hbtounes/projet-Arduino-Bentounes-Cayla/README.md

# projet-Arduino
Projet Arduino Hussein Ben Tounes Guillaume Cayla
