hbtounes/projet-Arduino-Bentounes-Cayla/Cayla Guillaume/rapport-seance-8.md

Durant cette 8ème séance, le bur était d'avancer sur le montage du bras+pince. Pour cela, je devais percer une sorte de petit écrou noir afin de pouvoir fixer les gros servomoteurs sur les éléments du bras. J'ai donc pris une mèche de 3mm et j'ai répété cette action sur 4 de ces petis objets noirs. Ensuite, j'ai dû trouver un moyen de visser ces derniers sur le bras et faire en sorte que la fixation soit solide et tienne bien. Pour cela, j'ai simplement trouver des entretoises du même diamètre que chaque vis et je les mises bout à bout comme cela : 



On peut donc remarquer que les servomoteurs sont fixés au bras à l'aide de ces 4 petits outils même si l'on ne voit rien.



De plus, durant cette séance, avec mon collègue Hussein, on a finalement réussi à faire tourner le moteur pas à pas à l'aide du téléphone via bluetooth :



Sur ces 3 boutons, l'un permet de le faire tourner dans le sens des aiguilles d'une montre, le second dans l'autre sens et enfin le dernier permet d'arrêter la rotation.
Par rapport au brannchement concernant le moteur pas à pas, le voici : 





On a vu dans la documentation de Pascal Masson que le moteur pas à pas nécessitait un driver A4988. En effet ce driver permet un contrôle très simple du moteur pas à pas. Ce montage nécessite une capacité de découplage pour l’alimentation du
moteur afin de lisser les appels de courant des bobines

Finalement je pense avoir plutot bien respecté le diagramme de Gantt : 
