hbtounes/projet-Arduino-Bentounes-Cayla/Cayla Guillaume/rapport-seance-7.md

Durant cette 7ème séance, mon rôle était de m'occuper de la partie bluetooth du projet. Pour cela je devais d'abord me concentrer sur le contrôle du moteur DC via le téléphone. Pour cela, il a fallut connecter le module bluetooth à la carte Arduino comme on peut le voir sur la photo ci-dessous.



Ensuite, il a fallut que je me familiarise avec l'application mobile "Bluetooth Electronics" déjà installée lors d'un TD en début d'année. J'ai donc dû faire mes recherches et trouver des tutos ou bien des indications concernant l'utilisation de cette application. Suite à cela, j'ai également regardé le contrôle bluetooth dans le cadre du code sur Arduino IDE. 



On peut voir dans le code ci-dessus la création de deux variables : un "int" (PWM) et un "char" (DATA). En effet le caractère char va permettre de stocker un caractère et par la suite d'introduire toutes les conditions nécessaires au bon fonctionnement du projet. C'est-à-dire que sur l'application, on caractérise la bifurcation vers la droite de la voiture à l'aide de la lettre "R" (Right). 



Cette même lettre va être stocké dans la variable DATA et on pourra créer les premières conditions pour que la voiture tourne à droite. Ensuite je n'ai plus qu'a coder l'action de tourner les roues avant et voilà le tour est joué !



Maintenant, par rapport à la variable "int", cette dernière va servir à stocker la valeur que l'on va choisir avec l'application. Par exemple, dans mon interface de l'application, j'ai un curseur qui renvoi une variable lorsqu'on le bouge vers la droite ou vers la gauche. Je passe ensuite cette variable dans les paramètres de la méthode qui sert à faire avancer plus ou moins les roues arrières. Tout cela pour faire en sorte qu'on puisse contrôler les roues arrières à volonté. 



Finalement j'ai eu un peu de mal à faire fonctionner les moteurs DC à l'aide du bluetooth. Il y a encore un souci que je n'arrive pas encore à résoudre. Mais j'ai tout de même réussi à controler le servomoteur qui va permettre de faire tourner les deux roues avant de la voiture.

Finalement je pense avoir plus ou moins respecté le diagramme de Gantt : 
