hbtounes/projet-Arduino-Bentounes-Cayla/Cayla Guillaume/rapport-seance-6.md

Durant cette séance, il aurait fallu que je commence à m'intéresser à la partie bluetooth de notre projet. Mais suite à beaucoup d'imprévus, cet objectif sera reporté à la semaine prochaine. En effet, durant cette 6ème séance, je me suis remis sur la partie branchement de la voiture afin de pouvoir avancé avec une bonne base. Mais  les nombreux faux-contacts et la mauvaise qualité de nos cables m'a fait perdre énormément de temps. Malgré cela j'ai tout de même réussi à tout faire fonctionner (c'est-à-dire faire tourner les deux roues arrières et faire en sorte que tous les composants soient fixer sur la base du robot)



Après avoir réussi cela, j'ai commecé à me remémorer le cablage et le code pour le bon fonctionnement de notre servomoteur qui va permettre de faire pivoter les deux roues avant. Puisque le code utilisé durant ces 6 dernières séances était le code pour les roues arrières, il a fallu que j'implémente le code du servomoteur dans ce premier. Pour cela je me suis encofe inspiré du document "moteur" de Mr.Masson sur lequel on avait travaillé auparavant.





Pendant une bonne trentaine de minutes, on a expliqué d'une part notre projet à des lycéens (c'est-à-dire les difficulutés rencontrées, les idées, la manipulation, le code...) et d'autre part, on les a aiguillé dans tout ce qui est orientation et inquétudes de leur part concernant les spécialités. 

Finalement cette séance aura été plutôt frustrante pour ma part parce que je n'ai pas réussi ce que je voulais et cela nous met forcément mon coéquipier et moi en retard. Pour palier à ce retard, nous allons travaillé en dehors des séances hebdomadaire et avancer un maximum sur ce projet qui nous tient à coeur.

Finalement je n'ai pas bien respecté le diagramme de Gantt cette séance.
