hbtounes/projet-Arduino-Bentounes-Cayla/Cayla Guillaume/rapport-seance-5.md

Durant cette 5ème séance, mon but à moi était de finaliser le montage de notre projet afin de pouvoir passez à la suite : la pince mécanique. Pour cela j'ai directement commencé en fixant les différents modules sur la première planche de la voiture à savoir la carte Arduino, le pont en H et les piles. Il fallait d'abord mesurer le diamètre des trous des composants (pont en H et carte Arduino) et donc percer en fonction de cela. J'ai également fait un trou assez gros pour pouvoir faire passer les 4 fils des 2 moteurs DC. En effet, ces derniers sont déjà fixés sur le verso de la planche grâce au travail fourni en dehors des cours.



Comme on peut le voir sur l'image ci-dessus, j'ai pris des vis assez longues car on a pu visser les entretoises dans ces dernières afin de renforcer la fixation des différents composants. Suite à cela, en essayant l'efficacité de la "voiture", je me suis rendu compte que les deux roues arrières ne tournaient pas dans le même sens. Il a donc fallu modifier le code pour palier à ce petit obtsacle. On a enfin pu l'essayer dans les couloirs afin de voir si la puissance des roues était suffisante malgré le poids des planches et des composants. On est plutôt satisfait du résultat. Mais il reste encore un problème qu'on a pas encore résolu, c'est les roues avant qui sont reliées au servomoteur. Mon collègue Hussein a trouver un mécanisme permettant de faire tourner les 2 roues avant de façon ingénieuse mais il y avait de nombreux soucis au niveau du mécanisme : la matière est trop fragile, il faut essayer de rapprocher le plus possible les 2 roues et enfin, il faut fixer à l'aide de vis et non de tige filetée pour assurer une meilleure fixation.



L'image ci-dessus représente bien la situation. Il a donc fallu détacher tout le mécanisme et il va falloir tout reprendre à 0.

De plus, il fallait que je me penche sur le système d'interrupteur  car en effet, cela permettra de faire démarrer et d'arrêter la voiture. Pour cela, j'ai commencé à regarder des projets des années précédentes afin de m'inspirer des branchements car certains projets sont similaires au notre.



Puisque je n'ai pas trop eu le temps de m'informer sur ce sujet, ce sera le premier point que je vais aborder lors de la prochaine séance.

Je pense avoir respecté le diagramme de Gantt cette semaine.
