hbtounes/projet-Arduino-Bentounes-Cayla/Ben Tounes Hussein/Rapport-seance-3.md

Lors de cette séance de mon côté j'ai plutôt fait de la modélisation alors que Guillaume était plus concentré sur faire fonctionner le moteur D/C. 

Mon but était de terminer toute la modélisation pour que notre partie "voiture" soit enfin physiquement présente. 
Tout d'abord j'ai continer a essayer de travailler sur la connection entre le moteur D/C et les roues parce que j'avais crée une pièce de test qui prenait le moteur mais ne s'attachait pas à la roue. Donc j'ai fait une deuxième pièce test qui m'a permis d'attacher la roue à la pièce mais elle ne pouvait pas prendre le moteur.


J'ai donc du remodéliser une pièce avec des dimensions qui me semble les bonnes afin de connecter le moteur aux roues que je pouvait pas tester lors de la séance parce qu'elle s'est imprimé après la fin du cours, mais j'ai finis par la prendre le lendemain mais je ne l'ai toujours pas tester.


Sinon j'ai travailler sur des pièces ,que j'assemblerait la semaine prochaine ou si je peux dans mon temps libre, qui permettent à la voiture de tourner grâce au servo moteur.



Pour cette séance je n'ai pas entièrement respecter notre planning parcque j'était sensé ,à côté de la modélisation, commencer le code ou au moins regarder ce que je devait écrire. Malgrès cela, pendant les vacances j'ai profité de voir sur internet ce qui pourrait être fait au niveau du code afin de m'inspirer pour notre projet. Je suppose que cela est dû au temps d'attente pour imprimer puis recuperer sa pièce.


Je ferais de mon mieux de profiter des ressources fournies en dehors des heures de séance de cours afin de faire avancer le projet.
