hbtounes/projet-Arduino-Bentounes-Cayla/Ben Tounes Hussein/Rapport-seance-2.md

Lors de cette séance avec Guillaume on s'est principalement occupé de la construction du robot. Nous avons trouver deux planche avec une dimension de 25cmx30cm (que l'on peut réduire si cela est trop grand. Ensuite Guillaume à utilisé une perceuse pour troué les deux planches. De mon côté je modélisait une pièce "test" sur OnShape qui permettra de mettre en lien le moteur D/C avec les roues arrière.

Avec Guillaume on a choisit de prendre une tige fileté afin de mettre en lien les deux planches, on était aller au FabLab et on à utiliser une scie pour couper la tige en 4 à des distances un peu plus grande que 7cm. On a tout assemblé pour voir ce que ça donnait.

Cela nous permit de nous donner de la perspective de ce qu'il faut faire surtout avec le bras plus tard dans nos séance.
Tout au long de la séance si j'avait un peu de temps j'étudiais comment on aller mettre en place le circuit, cela n'est toujours pas fini parceque je dois regarder aussi pour le bras. Mais au niveau de la voiture, il serait idéale que cela soit fait d'ici une ou deux séances.

Sinon pour ma séance de cette semaine, je dirais que j'ai respecter ce qu'on avait planifié dans notre diagramme de Gantt.



Ainsi à la fin de la séance, j'ai utilisé une imprimante 3D pour avoir la pièce que j'avais modéliser et pour tester si ça rentre. Pour connecter au moteur c'est rentrer parfeaitement mais au niveau de la roue ça ne rentrait pas donc je dois soit réduire quelques dimensions ou sinon utiliser un outil qui me permettra d'enlever un peu de matière de la pièce.
