hbtounes/projet-Arduino-Bentounes-Cayla/Cayla Guillaume/rapport-seance-2.md

On a commencé par demander du matériel pour pouvoir enboîter les deux plaques qui constitueront le la base du robot.On nous a conseillé les entretoises. On a finalement vu que de la tige filetée était plus adéquat pour relier les deux bases. J'ai personnellement utilsé la perceuse pour réaliser les trous dans les quatre coins des deux plaques. Suite à cela il a fallu découper la tige en quatre morceaux à l'aide de la scie à métaux. On avait donc tous les composants pour finaliser l'étape d'aujourd'hui : relier les 2 bases. L'un des professeurs nous avait conseillé de superposer deux écrous et une rondelle plate pour chaque côté de la tige découpée auparavant afin d'assurer une meilleure fixation. Lors des trous réalisés dans les deux bases, j'ai essayé de gagner du temps en perçant les deux plaques en même temps. Mais il y a forcément du mouvement quand on perce. Par conséquent les trous sur la plaque du dessous étaient pas bien alignés avec celle du dessus. Il a donc fallu espacer les marques pour percer sur la deuxième plaque. On a finalement réussi à rattraper cette gaffe tant bien que mal. Après l'assemblage, 


j'ai rejoint Hussein sur son occupation à savoir : modéliser la pièce qui permettrait de relier le moteur DC avec les roues
Capture d'écran 2023-12-21 133305

Durant cette séance, j'ai plutôt bien respecté le diagramme de Gantt qu'on avait préparé au préalable durant la première séance.
