hbtounes/projet-Arduino-Bentounes-Cayla/Cayla Guillaume/rapport-seance-1.md

Durant cette première séance, de mon côté j’ai d'abord essayé de comprendre le fonctionnement d’un moteur utilisé pour les voitures. On nous a donc mis à disposition un moteur DC et un servomoteur. On a remarqué que notre moteur n’avait qu’un fil, il a donc fallu qu’on apprenne à utiliser la machine à souder afin de régler ce petit problème.



Par la suite, on a voulu déterminer la tension adéquat pour faire fonctionner le moteur ce qui a été fait à l'aide du générateur. 



Ensuite, j'ai essayé d'avancer sur la modélisation 3D de la base du robot. Avec Hussein on a décidé de faire une base de 50cm x 40cm. J'ai personnellement modélisé les 2 cercles. Le cercle du dessus va servir de socle pour la pince robotique.

Capture d'écran 2023-12-14 142621. 

L'un des nombreux projets des années précédentes nous a beaucoup inspiré et fait comprendre certaines parties du robot comme le fonctionnement du servomoteur qui va permettre d'effectuer les mouvements mécanique de la pince. Cela nous a également permi d'anticiper certains problèmes qui auraient pu nous arriver plus tard comme le poids de la pince qui n'est pas du tout négligeable. Il faudra donc ajuster la vitesse des roues et prendre en compte ce facteur important. On nous a égaklement mis a disposition un réglateur qui va nous permettre d'assurer un fonctionnement stable et fiable des composants.

Enfin j'ai testé de mon côté le servomoteur avec différents codes pour bien comprendre son fonctionnement encore une fois.
