hbtounes/projet-Arduino-Bentounes-Cayla/robotbras.pdf

# Voiture Bras !

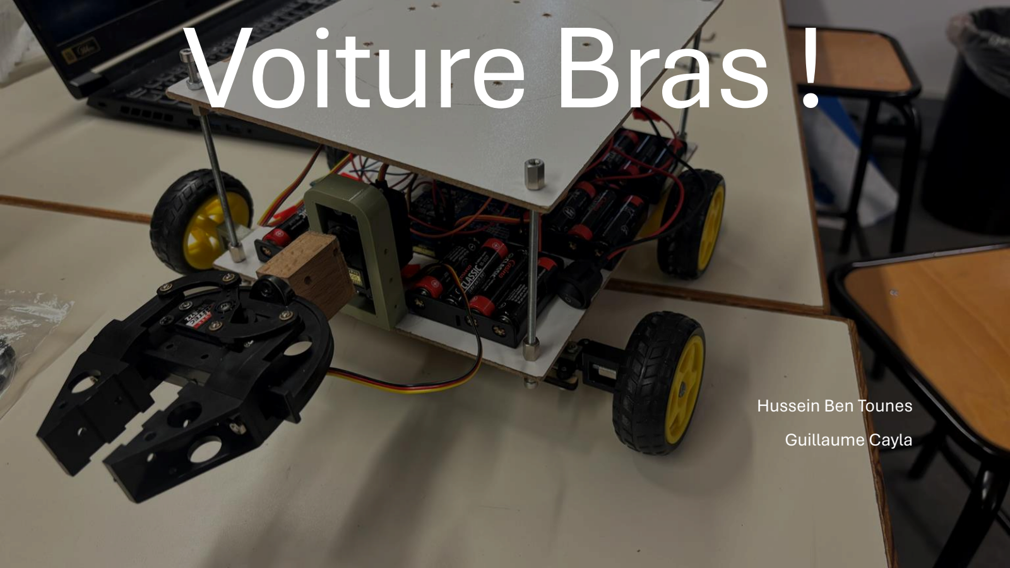
[picture p5: page 1]

Hussein Ben Tounes
Guillaume Cayla

# Quel est le but de ce projet ?

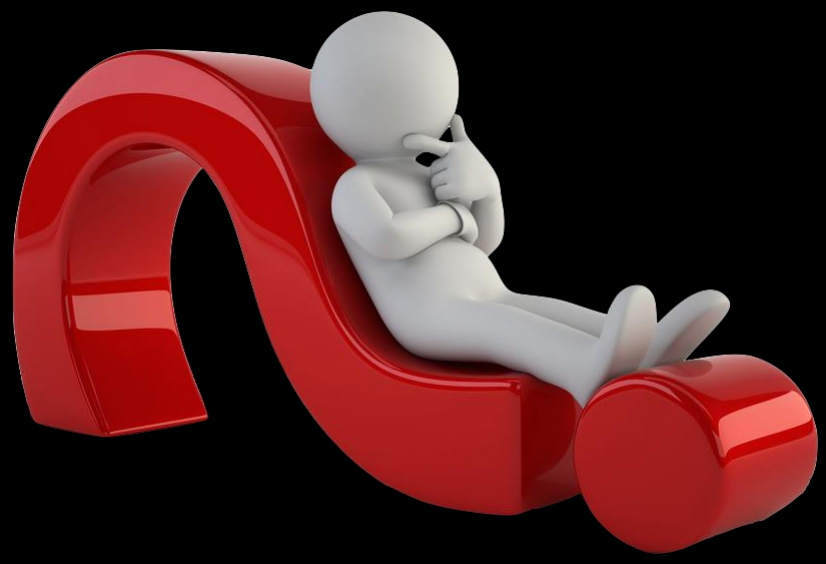
[picture p6: figure]

## Le But du projet

- Confectioner un robot qui fonctionne comme une voiture
- Ajouter une pince qui permet d’attraper tout type d’objet
- Contrôler tout ça avec module bluetooth + téléphone.

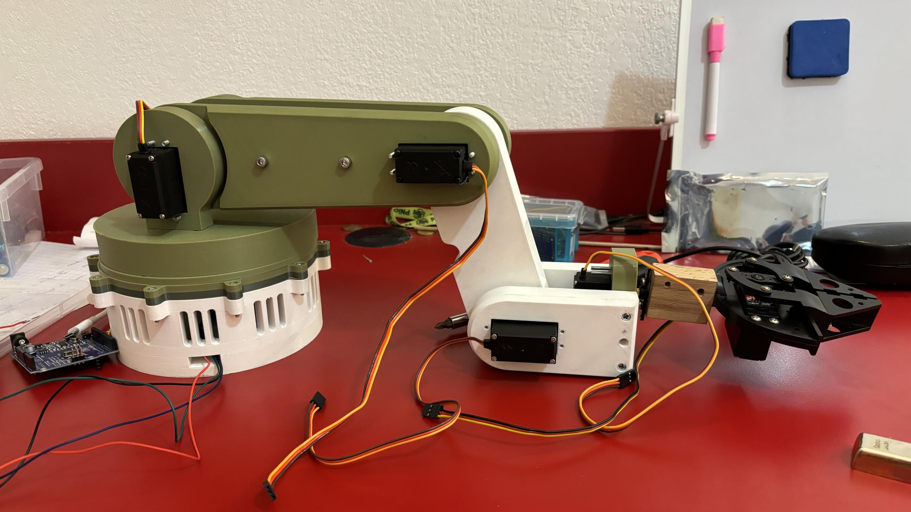
[picture p7: page 4]

# Matériels Electronique Utilisées

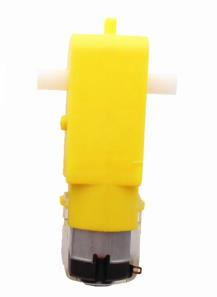
[picture p8: figure]
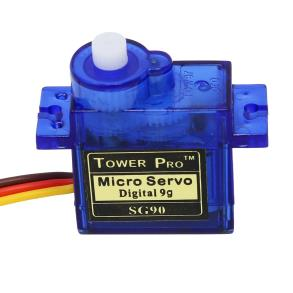
[picture p9: figure]
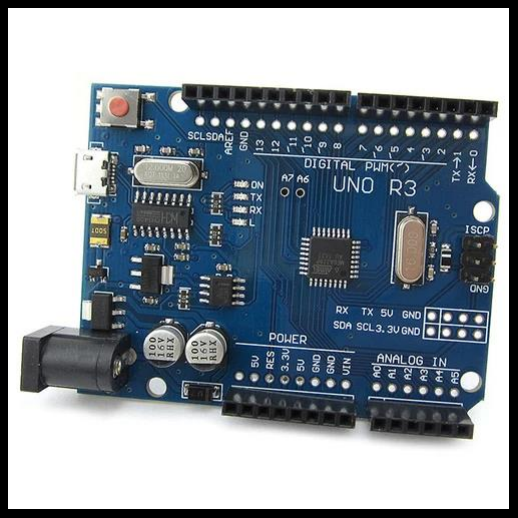
[picture p10: figure]

2 moteurs D/C | 1 micro servo moteur (180°)

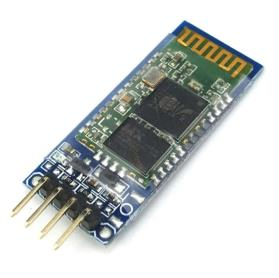
[picture p11: figure]
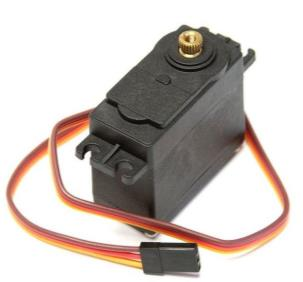
[picture p12: figure]

2 servo moteurs (180°) | Module bluetooth HC-06

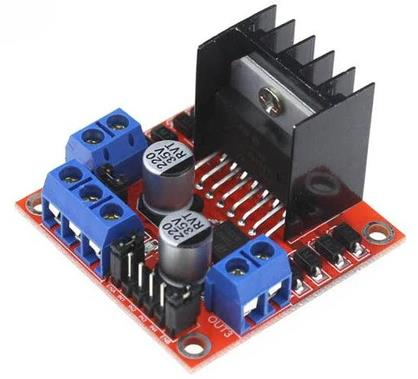
[picture p13: figure]
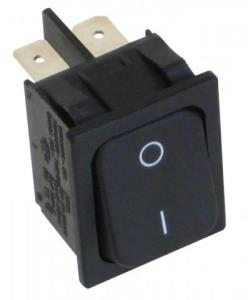
[picture p14: figure]
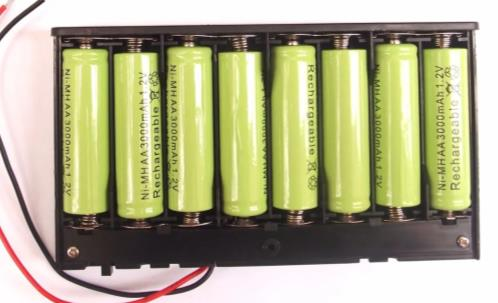
[picture p15: figure]
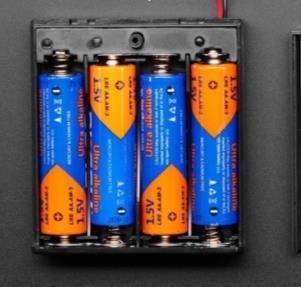
[picture p16: figure]

Pont-H L298N | 2 Alimentation de 6V | Alimentation de 12V | 2 Interrupteurs

Arduino UNO

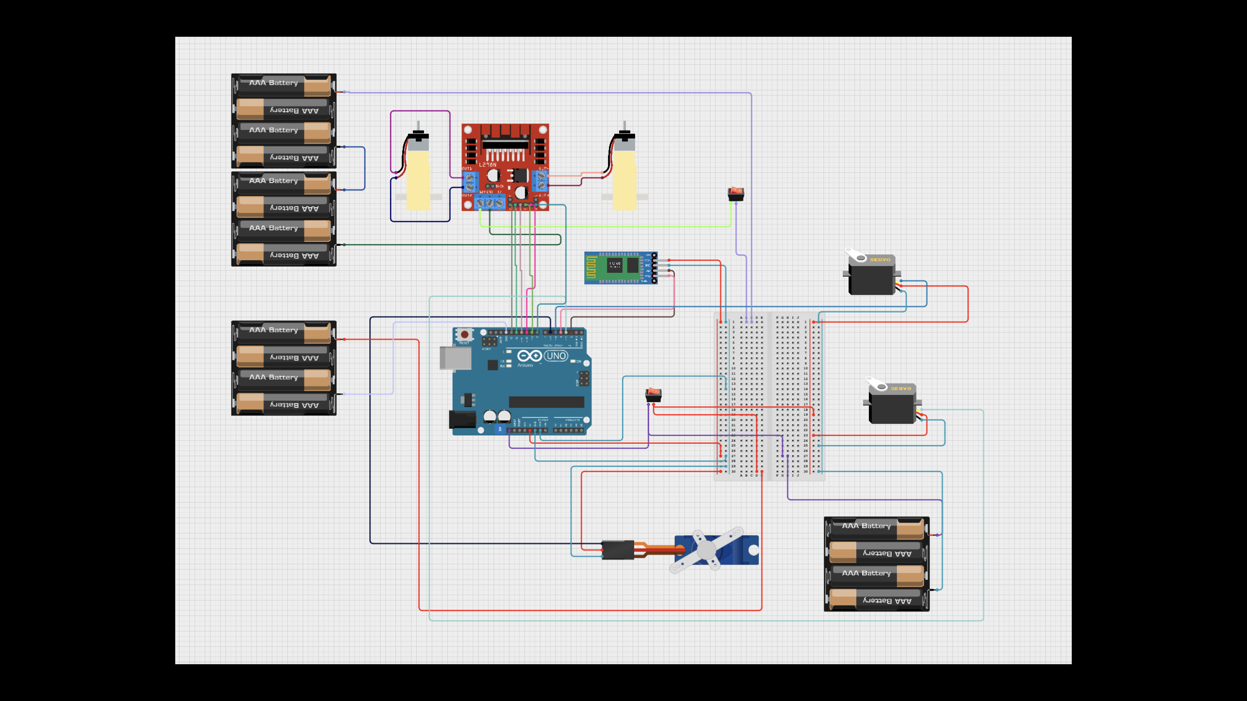
[picture p17: page 6]

## Comment fonctionne notre robot ?

### disposition des commandes

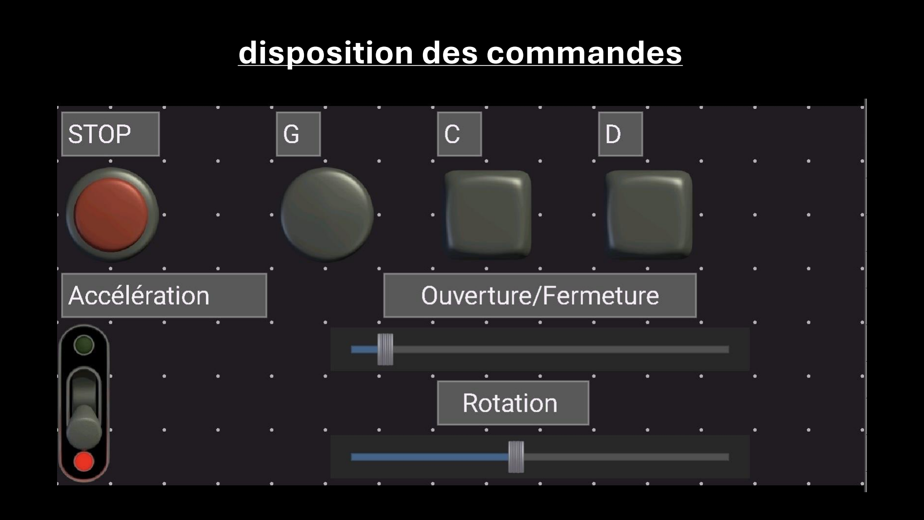
[picture p18: page 8]
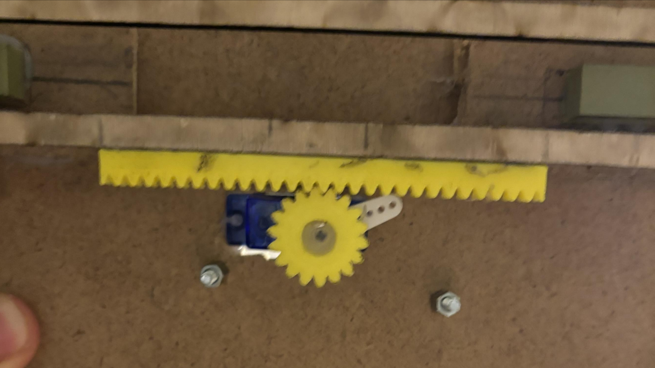
[picture p19: page 9]

# Conclusion / Bilan / Apports
