hbtounes/projet-Arduino-Bentounes-Cayla/Cayla Guillaume/rapport-seance-4.md

Durant cette 4ème séance, je savais directement ce que je devais faire à savoir finaliser la partie moteur + pont en H et aider Hussein sur la partie modélisation 3D
De plus, avec Hussein on a décidé de ne pas mettre 1 moteur DC pour l'entièreté de la voiture mais 2 moteurs DC car en effet, on a remarqué que 1 moteur n'est pas assez suffisant en terme de puissance pour notre projet. On sait de plus que le pont en h peut connecter deux moteurs donc il suffisait de le connecter directement. On a décidé de prendre des piles pour faire office de générateur pour la carte Arduino et pour le pont en H.



Avec Hussein, on a également pris la décision de réduire les deux planches qui servaient de support pour la voiture car ces dernières nous paraissaient trop grandes et donc trop fragile. J'ai donc eu recours à la découpe avec une scie à l'aide du personnel du FabLab. 



Suite à cette découpe, il a fallut refaire les trous dans les coins des planches à l'aide de la perceuse et d'une mèche de 4.5mm.
J'ai un peu modifié le code de la semaine dernière en y ajoutant le nécessaire pour que le deuxième moteur DC fonctionne correctement



Les deux intervenannts lors de cette séance nous ont posé quelques questions par rapport à la suite de notre projet. Suite à ces dernières, on a pris la décsion d'abandonner le controle bluetooth via le gant et on s'est plutôt rabattu sur un controle via le téléphone grâce à une application. Ce changement soudain est dû à la complexité de la conception de ce gant. C'est égalament à partir de cette séance qu'on a décidé de travailler en dehors des créneaux hebdomadaires imposés et de consacrer plus de temps à ce projet si l'on veut aller au bout de nos attente et en être fier.

Fianelement durant cette séance n°5, je n'ai pas completement respcté le diagramme de Gantt. Cela prouve qu'il va falloir passer la vitesse supérieur et s'organiser un peu mieux avec mon collègue Hussein.
